alamorobotics/W65C816_Keyboard_VGA_SID/Expansion_03.jpg

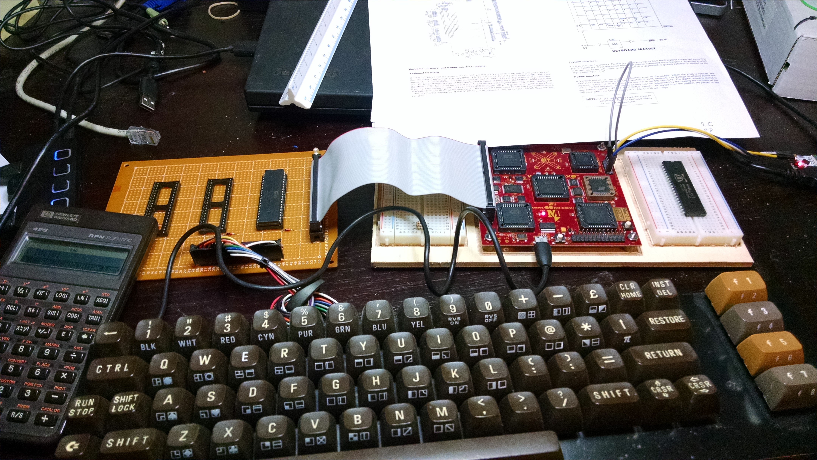
Expansion_03.jpg
