alamorobotics/W65C816_Keyboard_VGA_SID/Expansion_06.jpg

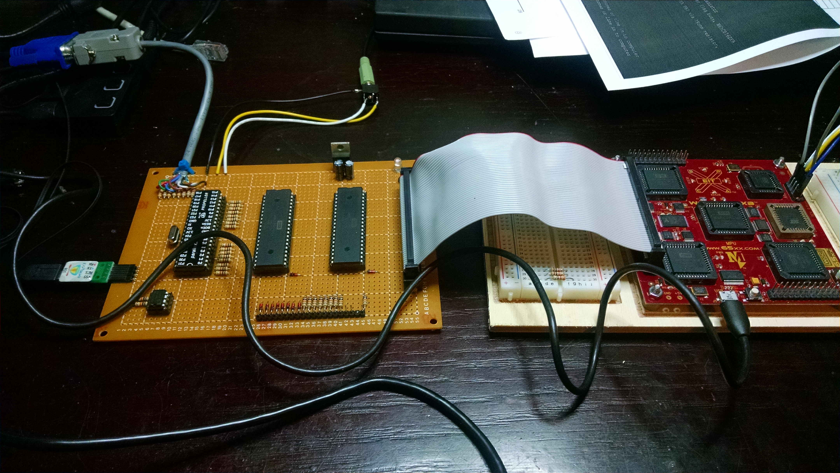
Expansion_06.jpg
