alamorobotics/W65C816_Keyboard_VGA_SID/Board.PNG

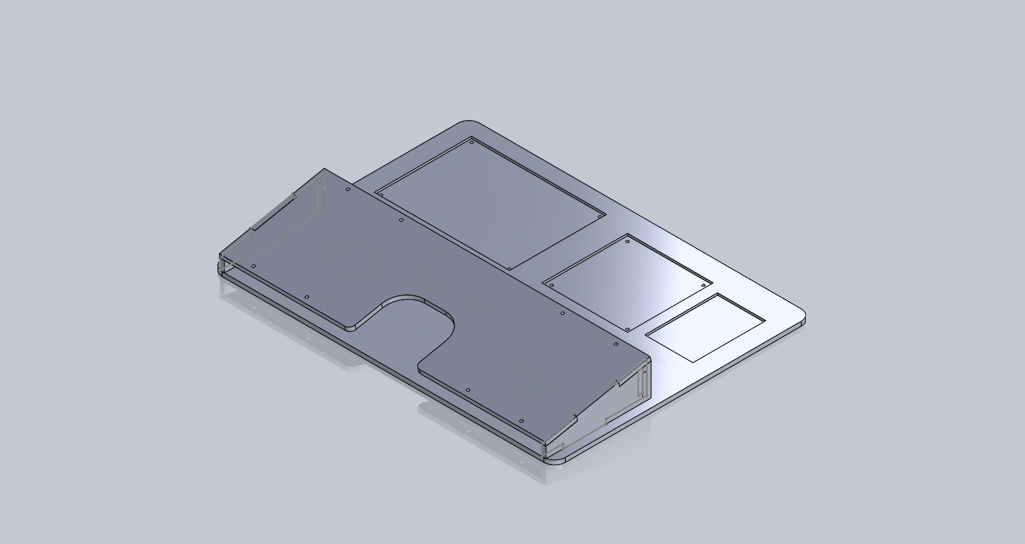
Board.PNG
