alamorobotics/W65C816_Keyboard_VGA_SID/Expansion_01.jpg

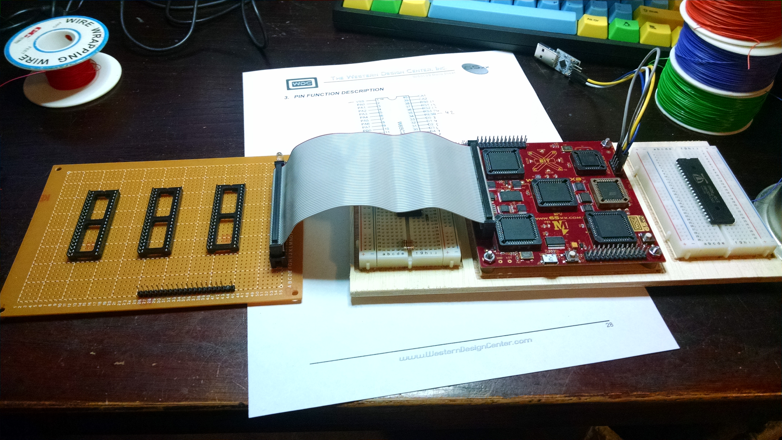
Expansion_01.jpg
