alamorobotics/W65C816_Keyboard_VGA_SID/Expansion_02.jpg

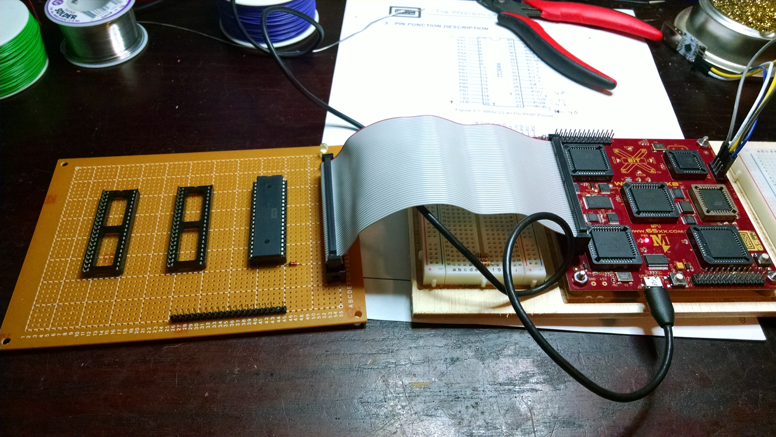
Expansion_02.jpg
