alamorobotics/W65C816_Keyboard_VGA_SID/Expansion_04.jpg

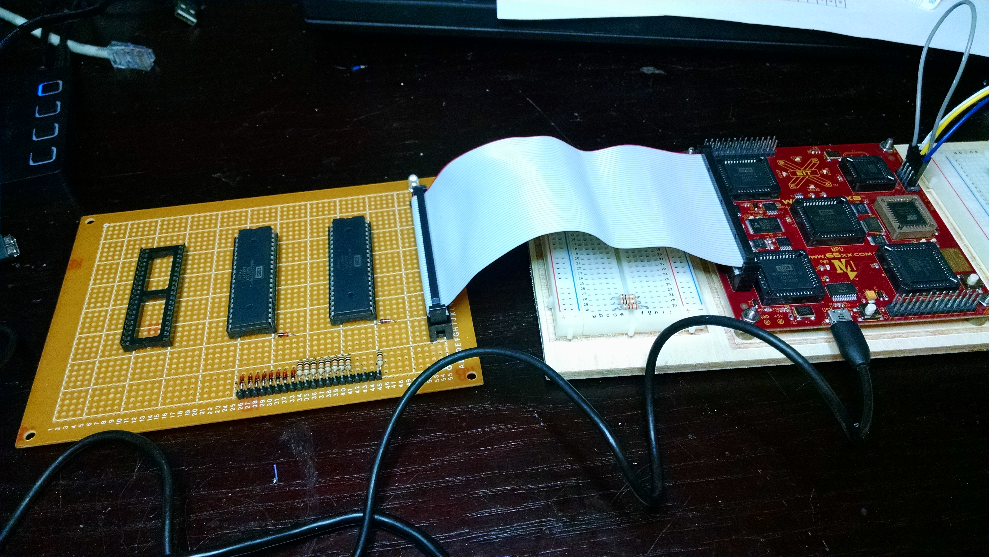
Expansion_04.jpg
