alamorobotics/W65C816_Keyboard_VGA_SID/Expansion_05.jpg

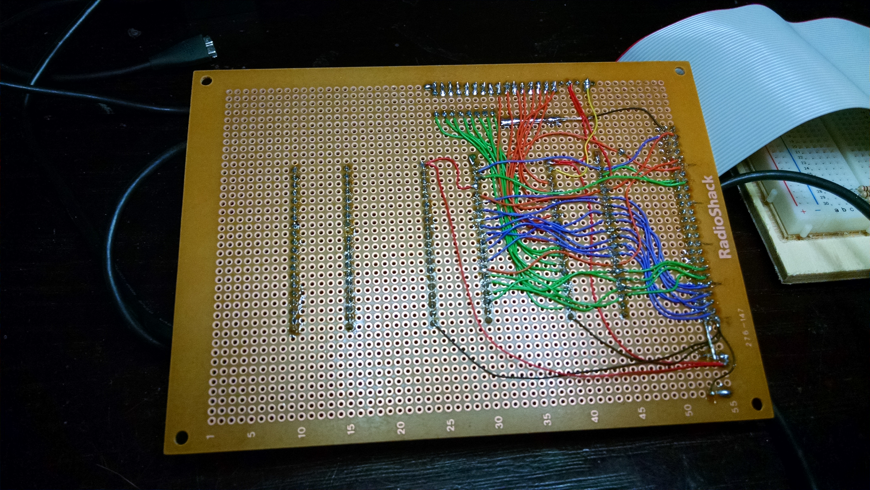
Expansion_05.jpg
