alamorobotics/W65C816_Keyboard_VGA_SID/Expansion_07.jpg

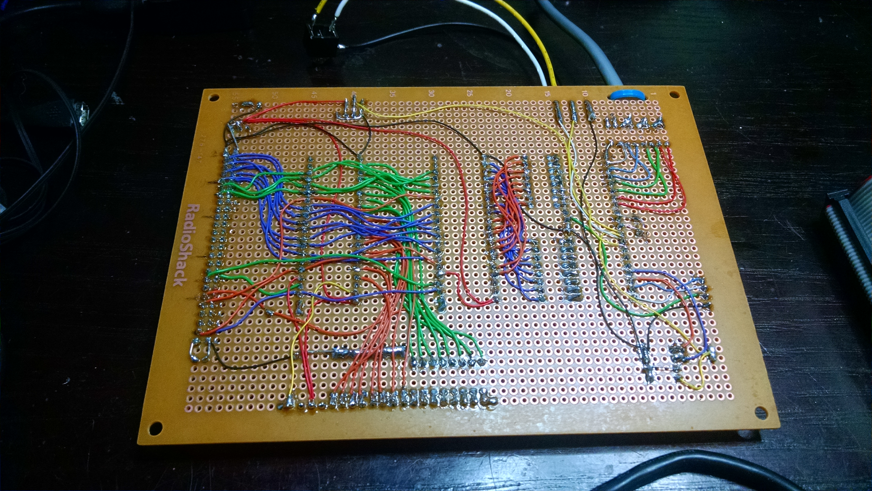
Expansion_07.jpg
