alamorobotics/W65C816_Keyboard_VGA_SID/Expansion_08.jpg

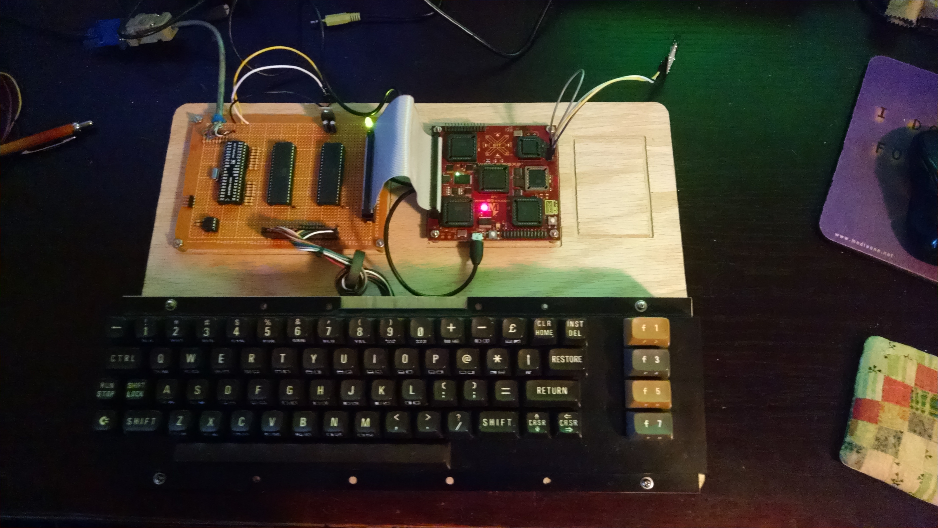
Expansion_08.jpg
