alamorobotics/W65C816_Keyboard_VGA_SID/Expansion_09.jpg

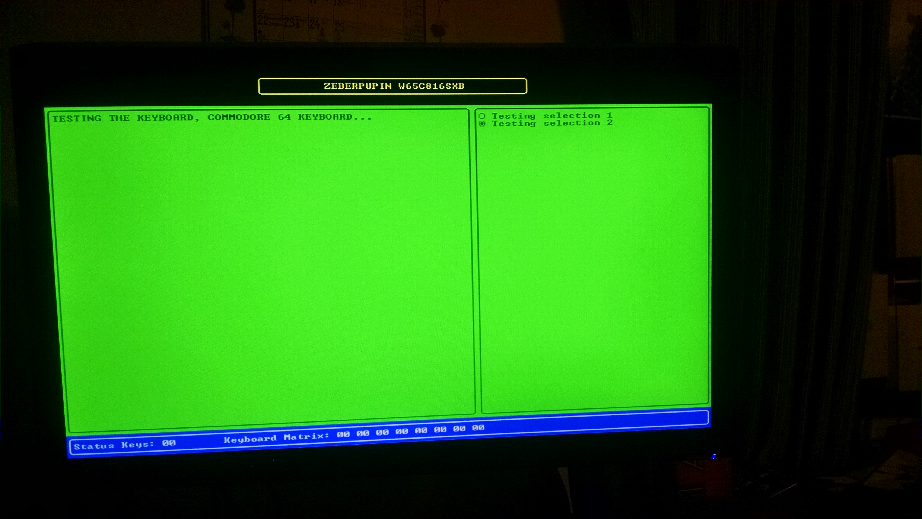
Expansion_09.jpg
