alamorobotics/W65C816_Keyboard_VGA_SID/Schematics_03.png

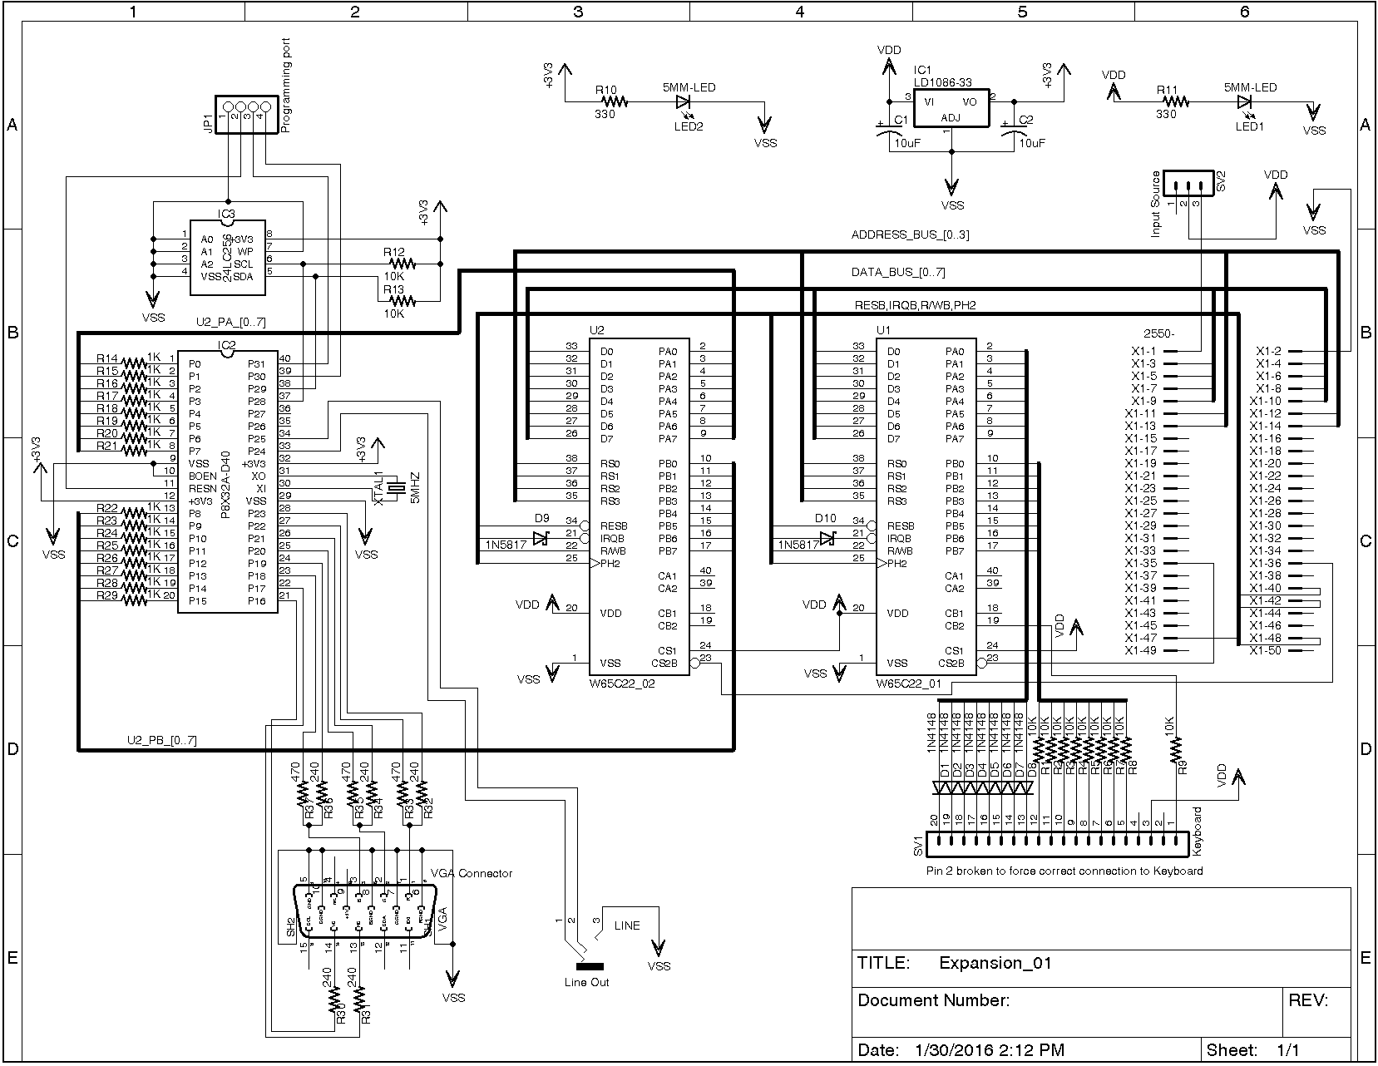
Schematics_03.png
