alamorobotics/W65C816_Keyboard_VGA_SID/Expansion_02.pdf

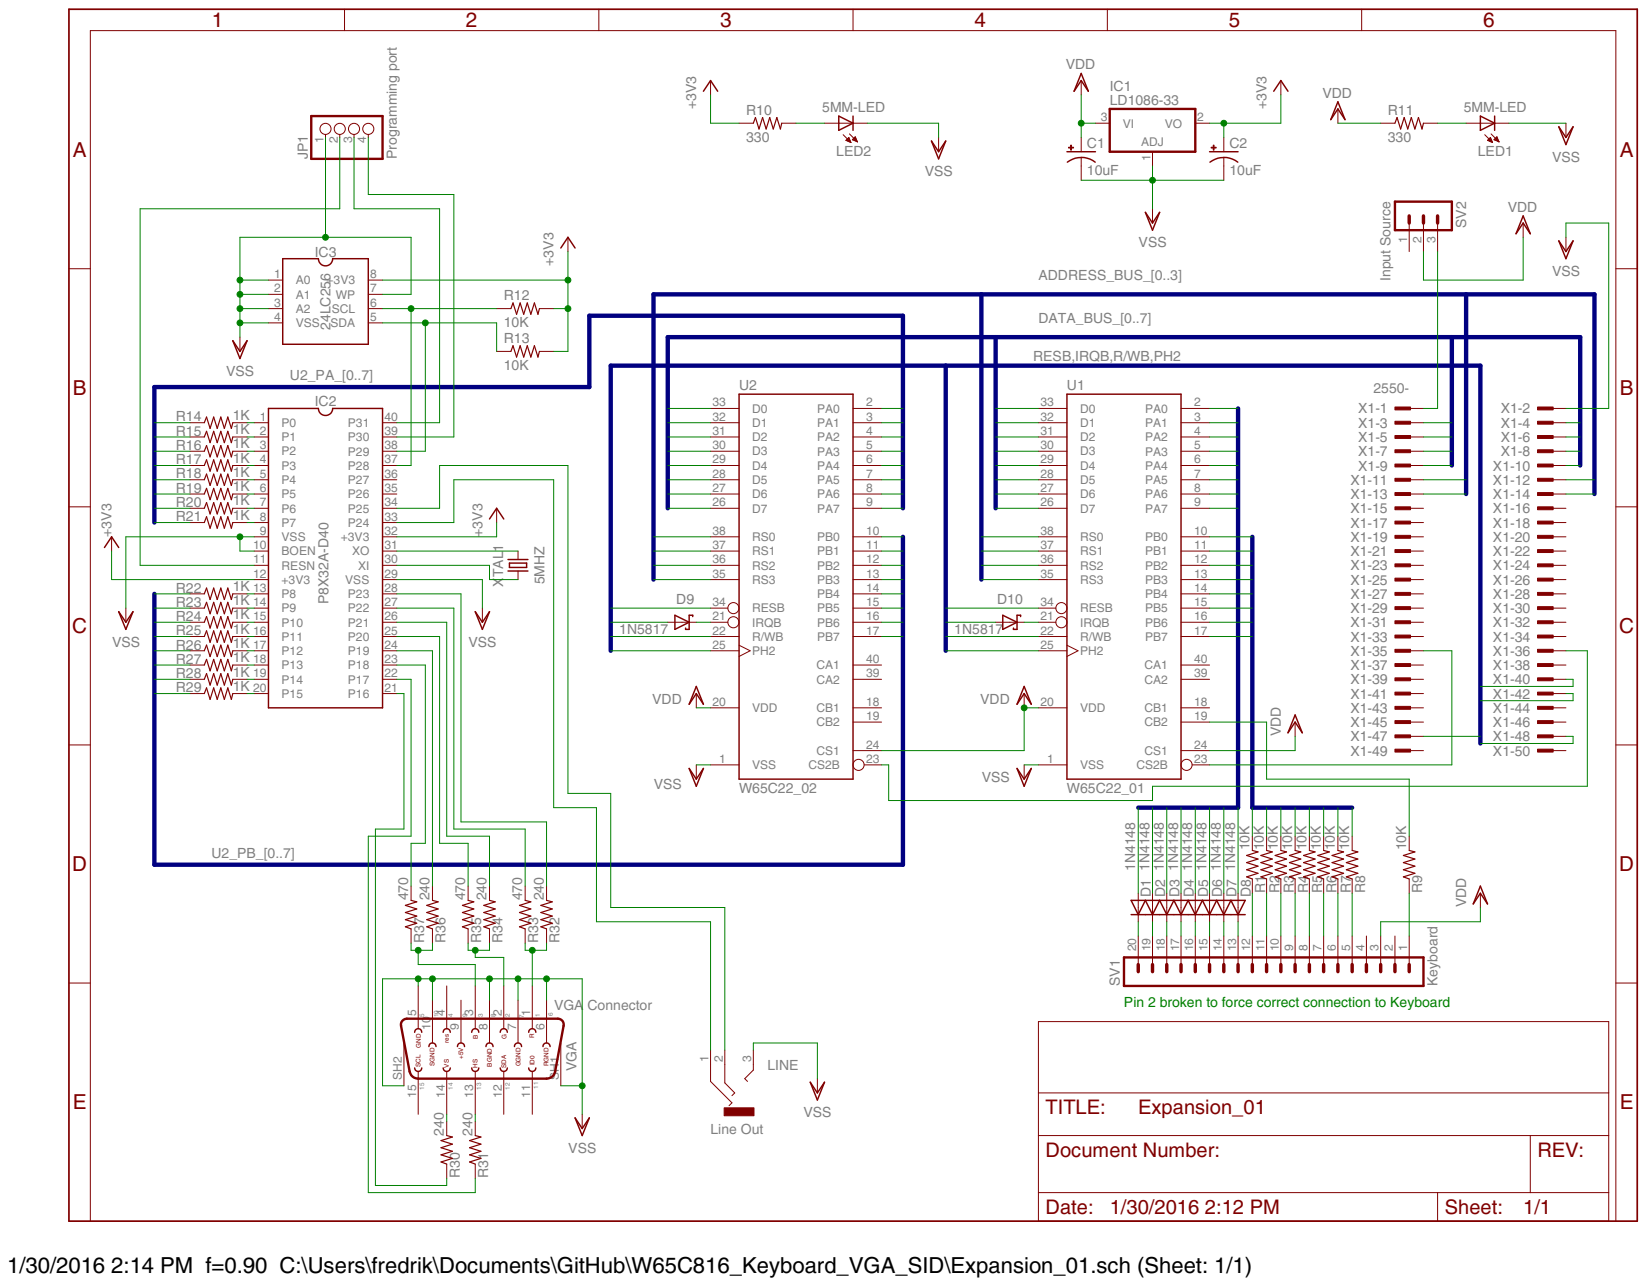
[picture p12: page 1]

DATA_BUS_[0..7]

RESB,IRQB,R/WB,PH2

Pin 2 broken to force correct connection to Keyboard

Document Number: | REV:

Date: 1/30/2016 2:12 PM | Sheet: 1/1

1/30/2016 2:14 PM f=0.90 C:\Users\fredrik\Documents\GitHub\W65C816_Keyboard_VGA_SID\Expansion_01.sch (Sheet: 1/1)
