alamorobotics/W65C816_Keyboard_VGA_SID/Expansion_01.brd

## EAGLE design Expansion_01.brd (2016-02-17)

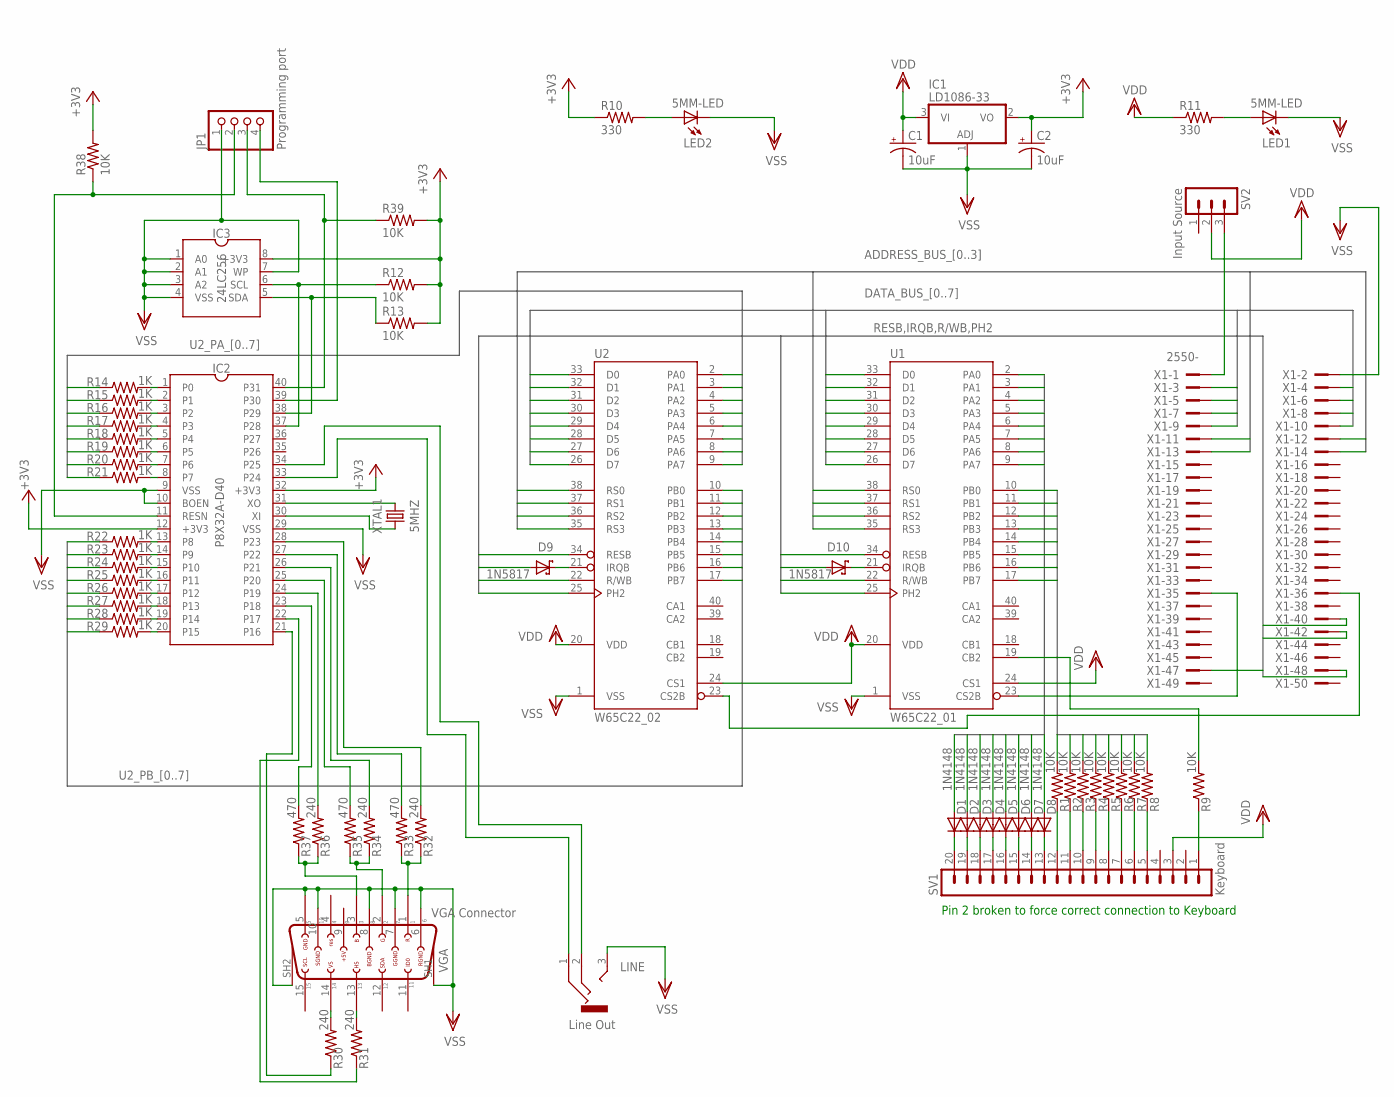
[picture p13: schematic Expansion_01.sch]

Parts:
C1, C2: 10uF; E2-5
D1, D2, D3, D4, D5, D6, D7, D8: 1N4148; DO35-7
D9, D10: 1N5817; DO41-7.6
IC1: LD1086-33; TO220H
IC2: P8X32A-D40DIP-40; P8X32A-D40
IC3: 24LC256DIP-8; 24LC256
JP1: Programming port; 1X04/90
LED1, LED2: 5MM-LED
LINE: Line Out; 1503_04
R1, R2, R3, R4, R5, R6, R7, R8, R9, R12, R13, R38, R39: 10K; 0207/10
R10, R11: 330; 0207/10
R14, R15, R16, R17, R18, R19, R20, R21, R22, R23, R24, R25, R26, R27, R28, R29: 1K; 0207/10
R30, R31, R32, R34, R36: 240; 0207/10
R33, R35, R37: 470; 0207/10
SV1: Keyboard; MA20-1
SV2: Input Source; MA03-1
U1: W65C22_01; DIP-40
U2: W65C22_02; DIP-40
VGA: VGA Connector; HD15F
X1: 2550-; PAK100/2500-50
XTAL1: 5MHZ; 5MHZ-CRYSTAL

Connections:
+3V3: C2.+, IC1.2 (VO), IC2.12 (+3V3), IC2.32 (+3V3), IC3.8 (+3V3), R10.1, R12.2, R13.2, R38.2, R39.2
ADDRESS_BUS_0: U1.38 (RS0), U2.38 (RS0), X1.11
ADDRESS_BUS_1: U1.37 (RS1), U2.37 (RS1), X1.12
ADDRESS_BUS_2: U1.36 (RS2), U2.36 (RS2), X1.13
ADDRESS_BUS_3: U1.35 (RS3), U2.35 (RS3), X1.14
DATA_BUS_0: U1.33 (D0), U2.33 (D0), X1.3, X1.4
DATA_BUS_1: U1.32 (D1), U2.32 (D1)
DATA_BUS_2: U1.31 (D2), U2.31 (D2), X1.5
DATA_BUS_3: U1.30 (D3), U2.30 (D3), X1.6
DATA_BUS_4: U1.29 (D4), U2.29 (D4), X1.7
DATA_BUS_5: U1.28 (D5), U2.28 (D5), X1.8
DATA_BUS_6: U1.27 (D6), U2.27 (D6), X1.9
DATA_BUS_7: U1.26 (D7), U2.26 (D7), X1.10
IRQB: D9.A, D10.A, X1.40
unnamed: SV2.3, X1.1
unnamed: D1.C, SV1.20
unnamed: D2.C, SV1.19
unnamed: D3.C, SV1.18
unnamed: D4.C, SV1.17
unnamed: D5.C, SV1.16
unnamed: D6.C, SV1.15
unnamed: D7.C, SV1.14
unnamed: D8.C, SV1.13
unnamed: R1.1, SV1.12
unnamed: R2.1, SV1.11
unnamed: R3.1, SV1.10
unnamed: R4.1, SV1.9
unnamed: R5.1, SV1.8
unnamed: R6.1, SV1.7
unnamed: R7.1, SV1.6
unnamed: R8.1, SV1.5
unnamed: R9.1, SV1.1
unnamed: R9.2, U1.19 (CB2)
unnamed: D10.C, U1.21 (IRQB)
unnamed: D9.C, U2.21 (IRQB)
unnamed: U1.23 (CS2B), X1.35
unnamed: U2.23 (CS2B), X1.36
unnamed: LED1.A, R11.2
unnamed: LED2.A, R10.2
unnamed: IC2.40 (P31), JP1.3, R39.1
unnamed: IC2.39 (P30), JP1.4
unnamed: IC2.31 (XO), XTAL1.2
unnamed: IC2.30 (XI), XTAL1.1
unnamed: IC2.11 (RESN), JP1.2, R38.1
unnamed: IC2.38 (P29), IC3.5 (SDA), R13.1
unnamed: IC2.37 (P28), IC3.6 (SCL), R12.1
unnamed: IC2.1 (P0), R14.2
unnamed: IC2.2 (P1), R15.2
unnamed: IC2.3 (P2), R16.2
unnamed: IC2.4 (P3), R17.2
unnamed: IC2.5 (P4), R18.2
unnamed: IC2.6 (P5), R19.2
unnamed: IC2.7 (P6), R20.2
unnamed: IC2.8 (P7), R21.2
unnamed: IC2.13 (P8), R22.2
unnamed: IC2.14 (P9), R23.2
unnamed: IC2.15 (P10), R24.2
unnamed: IC2.16 (P11), R25.2
unnamed: IC2.17 (P12), R26.2
unnamed: IC2.18 (P13), R27.2
unnamed: IC2.19 (P14), R28.2
unnamed: IC2.20 (P15), R29.2
unnamed: R32.1, R33.1, VGA.1
unnamed: R34.1, R35.1, VGA.2
unnamed: R36.1, R37.1, VGA.3
unnamed: IC2.23 (P18), R37.2
unnamed: IC2.22 (P17), R31.1
unnamed: R30.2, VGA.14
unnamed: R31.2, VGA.13
unnamed: IC2.21 (P16), R30.1
unnamed: IC2.24 (P19), R36.2
unnamed: IC2.25 (P20), R35.2
unnamed: IC2.26 (P21), R34.2
unnamed: IC2.27 (P22), R33.2
unnamed: IC2.28 (P23), R32.2
unnamed: IC2.33 (P24), LINE.1
unnamed: IC2.34 (P25), LINE.2 (3)
PH2: U1.25 (PH2), U2.25 (PH2), X1.48
R/WB: U1.22 (R/WB), U2.22 (R/WB), X1.47
RESB: U1.34 (RESB), U2.34 (RESB), X1.42
U1_PA_0: D1.A, U1.2 (PA0)
U1_PA_1: D2.A, U1.3 (PA1)
U1_PA_2: D3.A, U1.4 (PA2)
U1_PA_3: D4.A, U1.5 (PA3)
U1_PA_4: D5.A, U1.6 (PA4)
U1_PA_5: D6.A, U1.7 (PA5)
U1_PA_6: D7.A, U1.8 (PA6)
U1_PA_7: D8.A, U1.9 (PA7)
U1_PB_0: R1.2, U1.10 (PB0)
U1_PB_1: R2.2, U1.11 (PB1)
U1_PB_2: R3.2, U1.12 (PB2)
U1_PB_3: R4.2, U1.13 (PB3)
U1_PB_4: R5.2, U1.14 (PB4)
U1_PB_5: R6.2, U1.15 (PB5)
U1_PB_6: R7.2, U1.16 (PB6)
U1_PB_7: R8.2, U1.17 (PB7)
U2_PA_0: R14.1, U2.2 (PA0)
U2_PA_1: R15.1, U2.3 (PA1)
U2_PA_2: R16.1, U2.4 (PA2)
U2_PA_3: R17.1, U2.5 (PA3)
U2_PA_4: R18.1, U2.6 (PA4)
U2_PA_5: R19.1, U2.7 (PA5)
U2_PA_6: R20.1, U2.8 (PA6)
U2_PA_7: R21.1, U2.9 (PA7)
U2_PB_0: R22.1, U2.10 (PB0)
U2_PB_1: R23.1, U2.11 (PB1)
U2_PB_2: R24.1, U2.12 (PB2)
U2_PB_3: R25.1, U2.13 (PB3)
U2_PB_4: R26.1, U2.14 (PB4)
U2_PB_5: R27.1, U2.15 (PB5)
U2_PB_6: R28.1, U2.16 (PB6)
U2_PB_7: R29.1, U2.17 (PB7)
VDD: C1.+, IC1.3 (VI), R11.1, SV1.3, SV2.2, U1.20 (VDD), U1.24 (CS1), U2.20 (VDD), U2.24 (CS1)
VSS: C1.-, C2.-, IC1.1 (ADJ), IC2.9 (VSS), IC2.10 (BOEN), IC2.29 (VSS), IC3.1 (A0), IC3.2 (A1), IC3.3 (A2), IC3.4 (VSS), IC3.7 (WP), JP1.1, LED1.K (C), LED2.K (C), LINE.3 (2), U1.1 (VSS), U2.1 (VSS), VGA.5, VGA.6, VGA.7, VGA.8, VGA.10, VGA.SH1, VGA.SH2, X1.2

Notes on the sheet:
Pin 2 broken to force correct connection to Keyboard

Board: 2 copper layers, 65 parts (0 on the bottom side), 114 nets, no tracks yet.
