alamorobotics/W65C816_Keyboard_VGA_SID/(commit log)

2016-01-25 Version 1.0
    Added first VIA...
    [W65C816_Keyboard_VGA_SID_01.obj]
2016-01-27 Added schematics.
    Added schematics.
    [Expansion_01.brd, Expansion_01.sch]
2016-01-30 Finished schematics
    Finished schematics
    [Expansion_01.brd, Expansion_01.sch]
2016-02-05 Propeller files etc...
    Propeller files etc...
    [VGA_SID_Key.obj, W65C816_Keyboard_VGA_SID_01.obj]
2016-02-17 Fixed Schematics
    Fixed Schematics
    [Expansion_01.brd, Expansion_01.sch]
2016-02-17 Cleanup
    Cleanup
    [VGA_SID_Key.obj, W65C816_Keyboard_VGA_SID_01.obj]
